ifilot/QS-80/pcb/components/TL16C2550PFBR.step

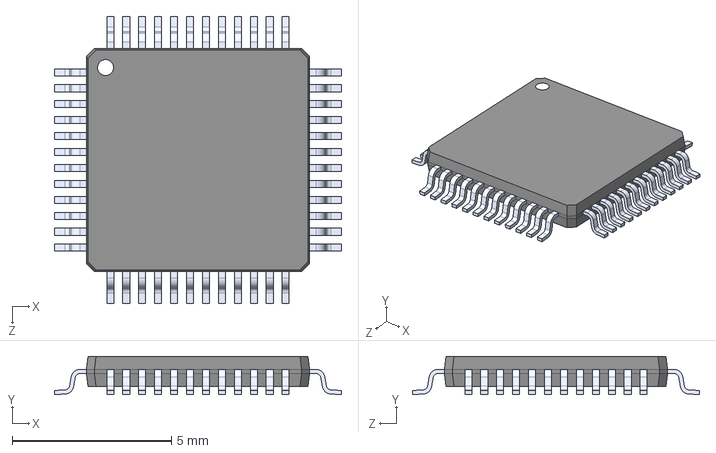
[picture p1: CAD file, 2026-08-23]
pcb/components/TL16C2550PFBR.step
9.00 x 1.20 x 9.00 mm
