ifilot/QS-80/pcb/qs-80-review.pdf

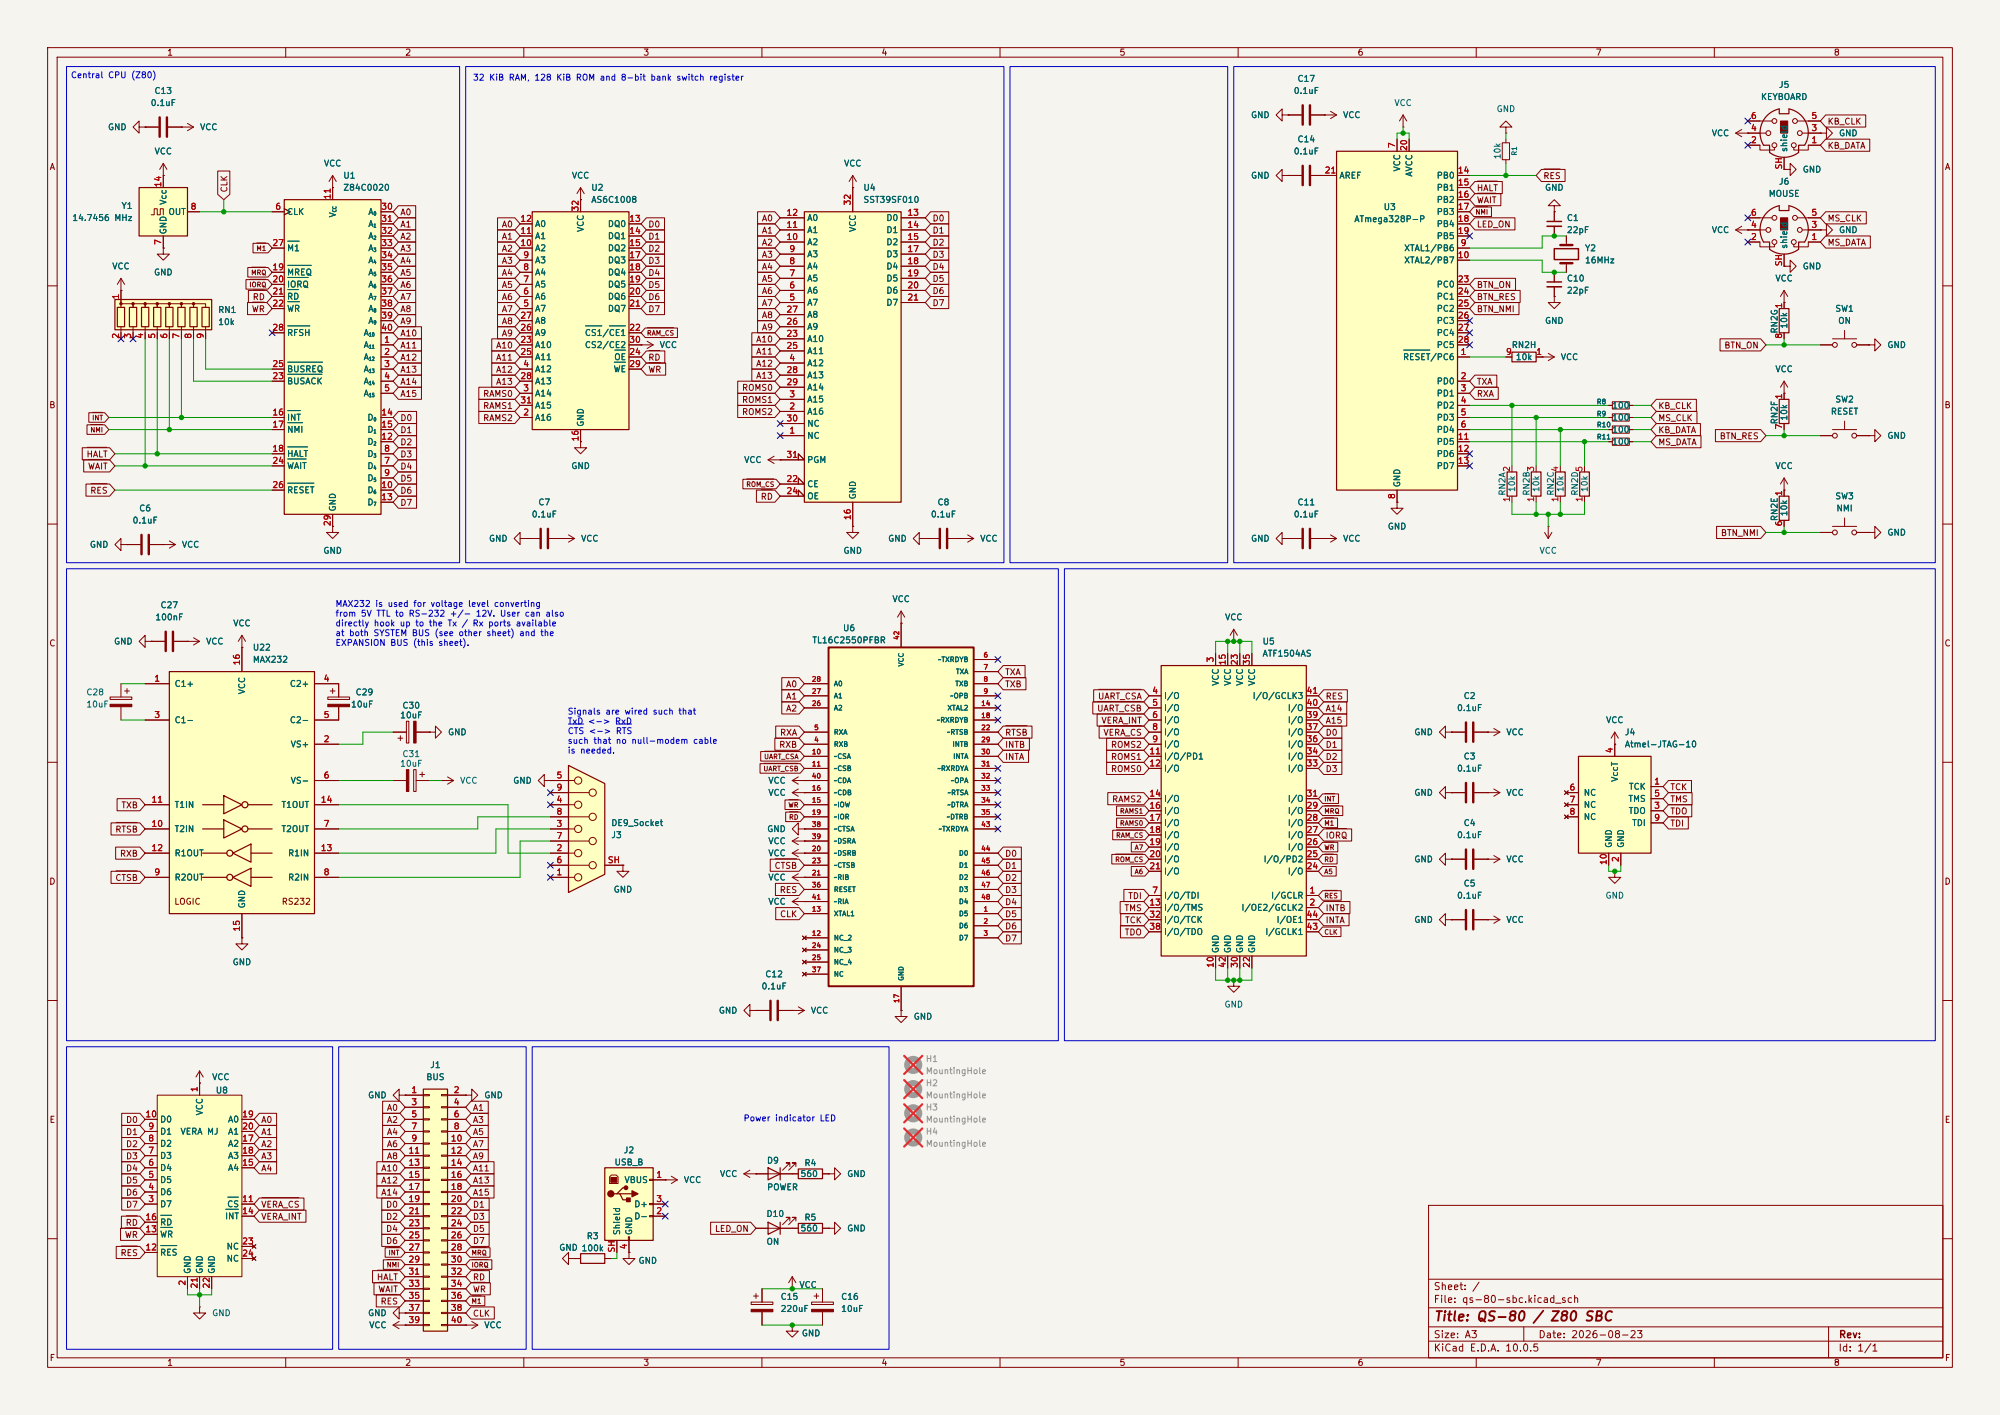
[picture p2: page 1]

32 KiB RAM, 128 KiB ROM and 8-bit bank switch register

VCC 11 D2 12 D7 13 D0 14 D1 15 INT 16 NMI 17 HALT 18 MREQ 19

from 5V TTL to RS-232 +/- 12V. User can also
directly hook up to the Tx / Rx ports available at both SYSTEM BUS (see other sheet) and the EXPANSION BUS (this sheet).

Signals are wired such that TxD <-> RxD

CTS <-> RTS
such that no null-modem cable
is needed.
