ifilot/QS-80/pcb/qs-80-sbc.kicad_pcb

## KiCad design pcb/qs-80-sbc.kicad_pcb (2026-08-30)

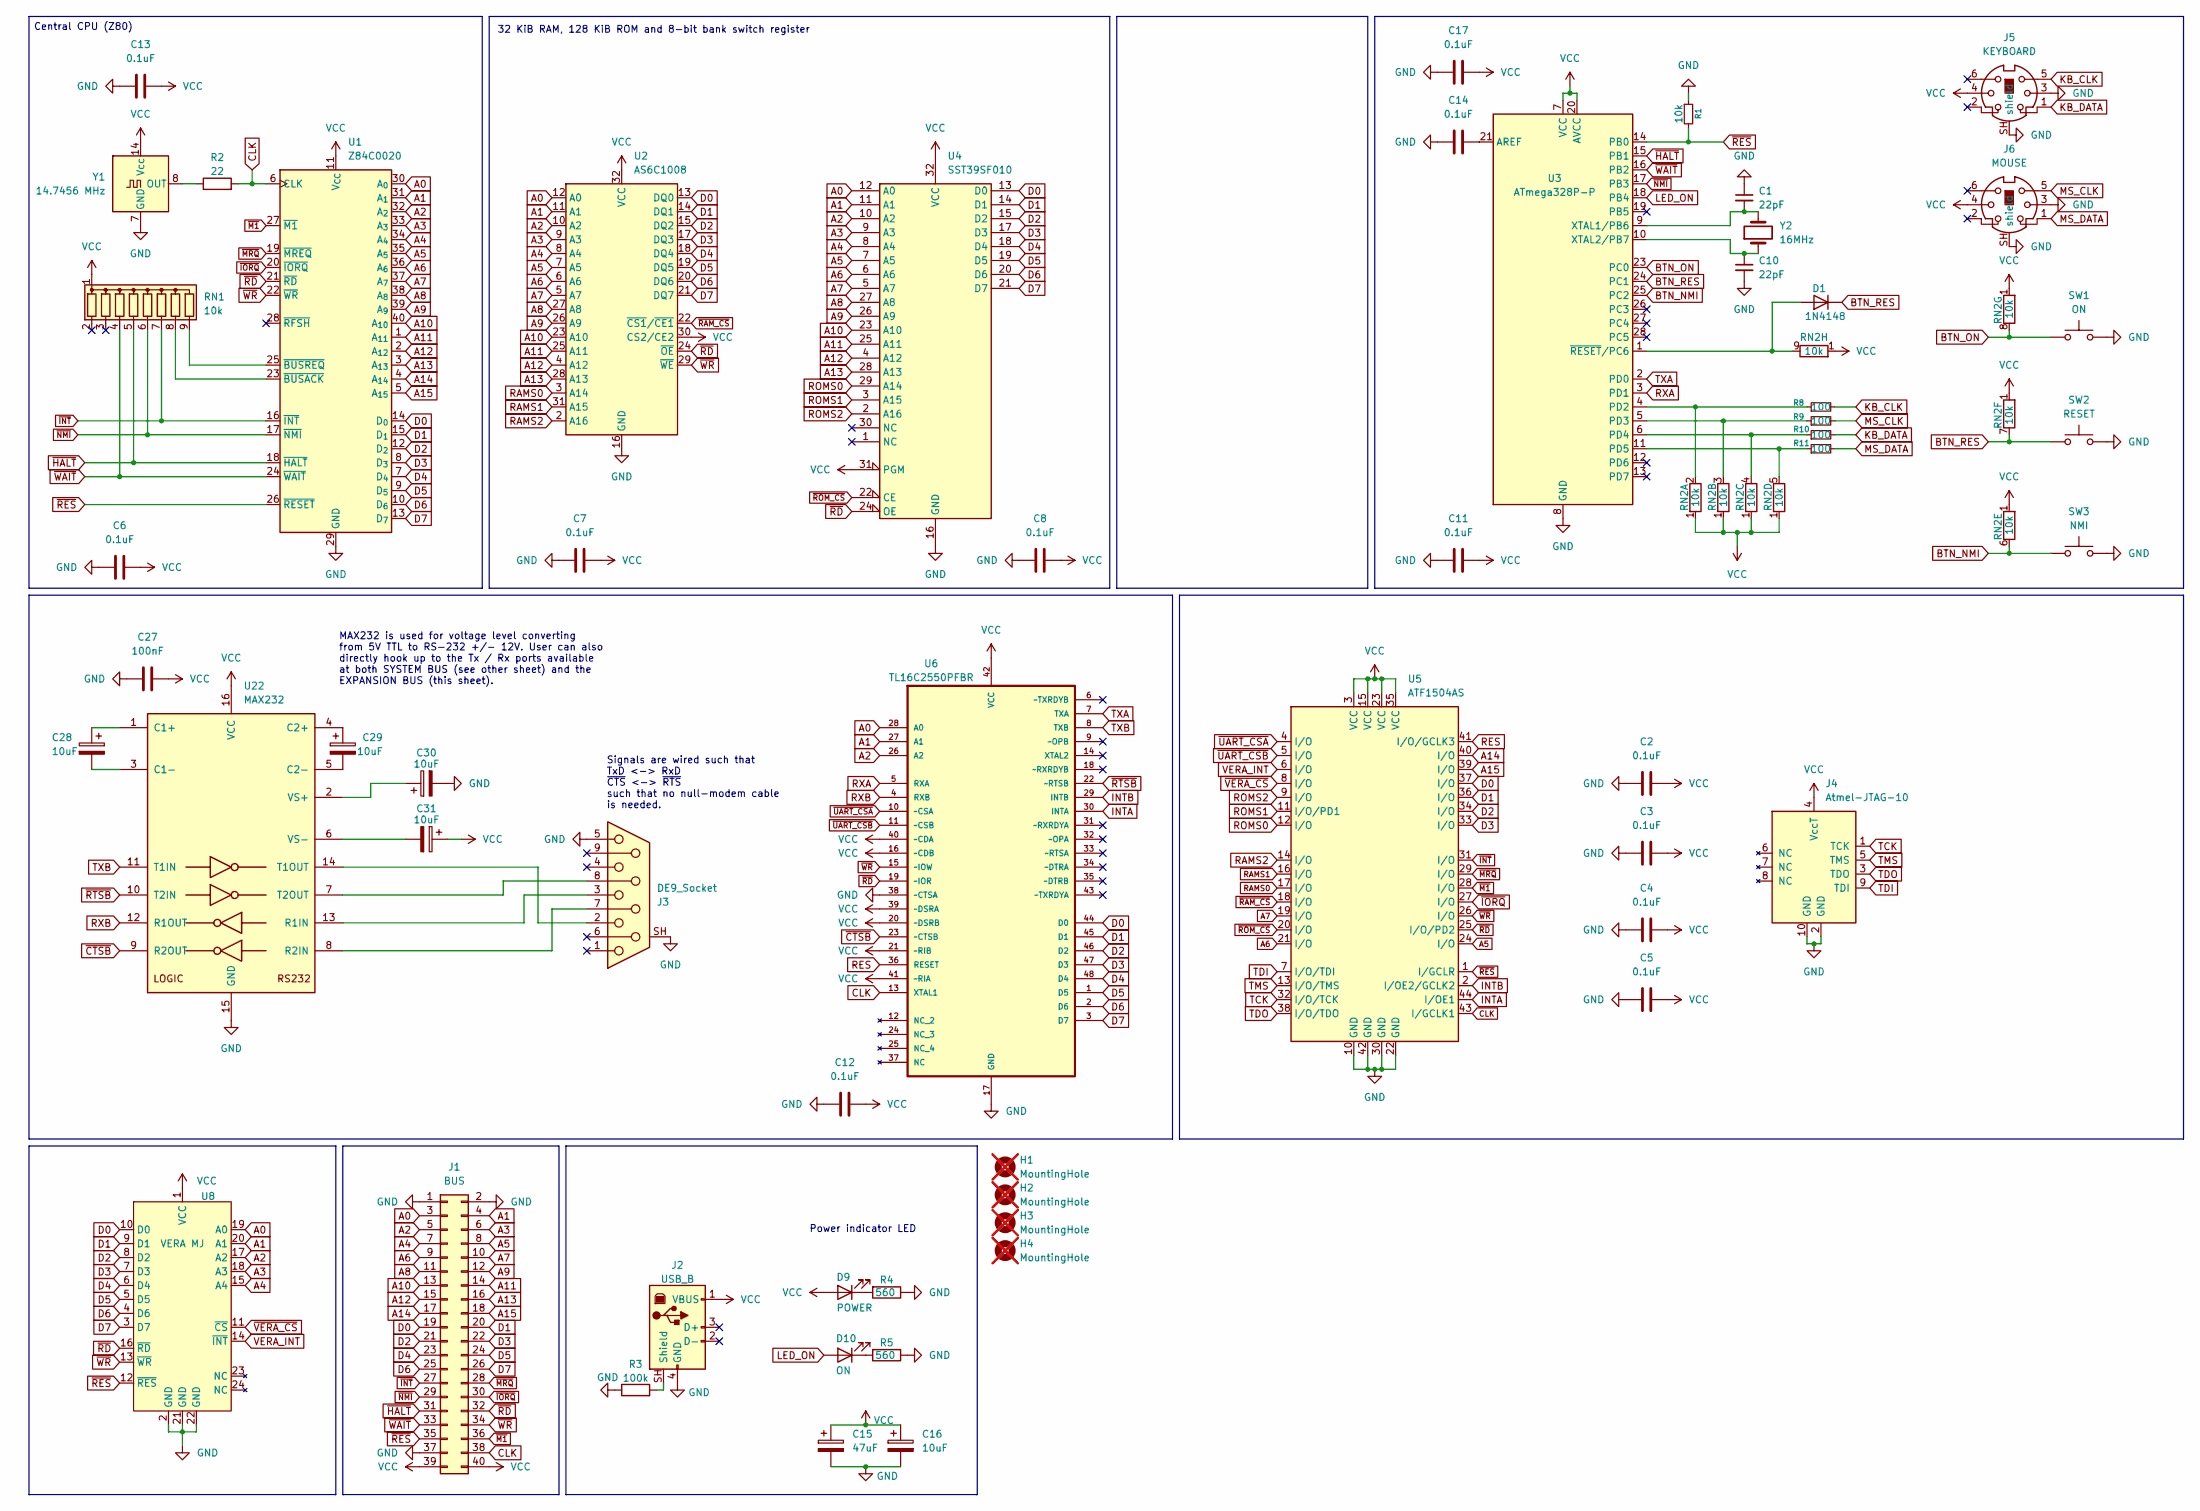
[picture p3: schematic qs-80-sbc.kicad_sch, QS-80 / Z80 SBC]

Parts:
C1, C10: 22pF; C_Disc_D5.0mm_W2.5mm_P5.00mm
C2, C3, C4, C5, C6, C7, C8, C11, C12, C13, C14, C17: 0.1uF; C_Disc_D5.0mm_W2.5mm_P5.00mm
C15: 47uF; CP_Radial_D6.3mm_P2.50mm
C16, C28, C29, C30, C31: 10uF; CP_Radial_D5.0mm_P2.50mm
C27: 100nF; C_Disc_D5.0mm_W2.5mm_P5.00mm
D1: 1N4148; D_DO-35_SOD27_P7.62mm_Horizontal
D9: POWER; LED_D5.0mm
D10: ON; LED_D5.0mm
H1, H2, H3, H4: MountingHole; MountingHole_3.2mm_M3_DIN965_Pad; not fitted
J1: BUS; PinHeader_2x20_P2.54mm_Vertical
J2: USB_B; USB_B_OST_USB-B1HSxx_Horizontal
J3: DE9_Socket; DSUB-9_Pins_Horizontal_P2.77x2.84mm_EdgePinOffset4.94mm_Hou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
J4: Atmel-JTAG-10; IDC-Header_2x05_P2.54mm_Vertical
J5: KEYBOARD; J_Mini-DIN-6
J6: MOUSE; J_Mini-DIN-6
R1: 10k; R_Axial_DIN0207_L6.3mm_D2.5mm_P7.62mm_Horizontal
R2: 22; R_Axial_DIN0207_L6.3mm_D2.5mm_P7.62mm_Horizontal
R3: 100k; R_Axial_DIN0207_L6.3mm_D2.5mm_P7.62mm_Horizontal
R4, R5: 560; R_Axial_DIN0207_L6.3mm_D2.5mm_P7.62mm_Horizontal
R8, R9, R10, R11: 100; R_Axial_DIN0207_L6.3mm_D2.5mm_P7.62mm_Horizontal
RN1, RN2: 10k; R_Array_SIP9
SW1: ON; SW_PUSH_6mm
SW2: RESET; SW_PUSH_6mm
SW3: NMI; SW_PUSH_6mm
U1: Z84C0020; DIP-40_W15.24mm_Socket
U2: AS6C1008; DIP-32_W15.24mm_Socket
U3: ATmega328P-P; DIP-28_W7.62mm_Socket
U4: SST39SF010; DIP-32_W15.24mm_Socket
U5: ATF1504AS; PLCC-44_THT-Socket
U6: TL16C2550PFBR; TQFP-48_7x7mm_P0.5mm; MPN TL16C2550PFBR
U8: VERA MJ; veraboard
U22: MAX232; DIP-16_W7.62mm_Socket
Y1: 14.7456 MHz; Oscillator_DIP-14
Y2: 16MHz; Crystal_HC49-U_Vertical

Connections:
A0: J1.3, U1.30 (A_{0}), U2.12 (A0), U4.12 (A0), U6.28 (A0), U8.19 (A0)
A1: J1.4, U1.31 (A_{1}), U2.11 (A1), U4.11 (A1), U6.27 (A1), U8.20 (A1)
A2: J1.5, U1.32 (A_{2}), U2.10 (A2), U4.10 (A2), U6.26 (A2), U8.17 (A2)
A3: J1.6, U1.33 (A_{3}), U2.9 (A3), U4.9 (A3), U8.18 (A3)
A4: J1.7, U1.34 (A_{4}), U2.8 (A4), U4.8 (A4), U8.15 (A4)
A5: J1.8, U1.35 (A_{5}), U2.7 (A5), U4.7 (A5), U5.24 (I/O)
A6: J1.9, U1.36 (A_{6}), U2.6 (A6), U4.6 (A6), U5.21 (I/O)
A7: J1.10, U1.37 (A_{7}), U2.5 (A7), U4.5 (A7), U5.19 (I/O)
A8: J1.11, U1.38 (A_{8}), U2.27 (A8), U4.27 (A8)
A9: J1.12, U1.39 (A_{9}), U2.26 (A9), U4.26 (A9)
A10: J1.13, U1.40 (A_{10}), U2.23 (A10), U4.23 (A10)
A11: J1.14, U1.1 (A_{11}), U2.25 (A11), U4.25 (A11)
A12: J1.15, U1.2 (A_{12}), U2.4 (A12), U4.4 (A12)
A13: J1.16, U1.3 (A_{13}), U2.28 (A13), U4.28 (A13)
A14: J1.17, U1.4 (A_{14}), U5.40 (I/O)
A15: J1.18, U1.5 (A_{15}), U5.39 (I/O)
BTN_NMI: RN2.6 (R5.2), SW3.1, U3.25 (PC2)
BTN_ON: RN2.8 (R7.2), SW1.1, U3.23 (PC0)
BTN_RES: D1.1 (K), RN2.7 (R6.2), SW2.1, U3.24 (PC1)
CLK: J1.38, R2.2, U1.6 (CLK), U5.43 (I/GCLK1), U6.13 (XTAL1)
D0: J1.19, U1.14 (D_{0}), U2.13 (DQ0), U4.13 (D0), U5.37 (I/O), U6.44 (D0), U8.10 (D0)
D1: J1.20, U1.15 (D_{1}), U2.14 (DQ1), U4.14 (D1), U5.36 (I/O), U6.45 (D1), U8.9 (D1)
D2: J1.21, U1.12 (D_{2}), U2.15 (DQ2), U4.15 (D2), U5.34 (I/O), U6.46 (D2), U8.8 (D2)
D3: J1.22, U1.8 (D_{3}), U2.17 (DQ3), U4.17 (D3), U5.33 (I/O), U6.47 (D3), U8.7 (D3)
D4: J1.23, U1.7 (D_{4}), U2.18 (DQ4), U4.18 (D4), U6.48 (D4), U8.6 (D4)
D5: J1.24, U1.9 (D_{5}), U2.19 (DQ5), U4.19 (D5), U6.1 (D5), U8.5 (D5)
D6: J1.25, U1.10 (D_{6}), U2.20 (DQ6), U4.20 (D6), U6.2 (D6), U8.4 (D6)
D7: J1.26, U1.13 (D_{7}), U2.21 (DQ7), U4.21 (D7), U6.3 (D7), U8.3 (D7)
GND: C1.1, C2.2, C3.2, C4.2, C5.2, C6.2, C7.2, C8.2, C10.2, C11.2, C12.2, C13.2, C14.2, C15.2, C16.2, C17.2, C27.2, C30.2, J1.1, J1.2, J1.37, J2.4 (GND), J3.5, J3.SH (shield), J4.2 (GND), J4.10 (GND), J5.3, J5.SH (shield_SH), J6.3, J6.SH (shield_SH), R1.1, R3.1, R4.1, R5.1, SW1.2, SW2.2, SW3.2, U1.29 (GND), U2.16 (GND), U3.8 (GND), U3.22 (GND), U4.16 (GND), U5.10 (GND), U5.22 (GND), U5.30 (GND), U5.42 (GND), U6.17 (GND), U6.38 (~CTSA), U8.2 (GND), U8.21 (GND), U8.22 (GND), U22.15 (GND), Y1.7 (GND)
INTA: U5.44 (I/OE1), U6.30 (INTA)
INTB: U5.2 (I/OE2/GCLK2), U6.29 (INTB)
KB_CLK: J5.5, R8.2
KB_DATA: J5.1, R10.2
LED_ON: D10.2 (A), U3.18 (PB4)
MS_CLK: J6.5, R9.2
MS_DATA: J6.1, R11.2
unnamed: D1.2 (A), RN2.9 (R8.2), U3.1 (~RESET/PC6)
unnamed: D9.1 (K), R4.2
unnamed: D10.1 (K), R5.2
unnamed: J2.SH (Shield), R3.2
unnamed: RN1.8 (R7), U1.23 (~BUSACK)
unnamed: RN1.9 (R8), U1.25 (~BUSREQ)
unnamed: R8.1, RN2.2 (R1.2), U3.4 (PD2)
unnamed: R9.1, RN2.3 (R2.2), U3.5 (PD3)
unnamed: R10.1, RN2.4 (R3.2), U3.6 (PD4)
unnamed: R11.1, RN2.5 (R4.2), U3.11 (PD5)
unnamed: C14.1, U3.21 (AREF)
unnamed: C1.2, U3.9 (XTAL1/PB6), Y2.2
unnamed: C10.1, U3.10 (XTAL2/PB7), Y2.1
unnamed: C28.1, U22.1 (C1+)
unnamed: C28.2, U22.3 (C1-)
unnamed: C29.1, U22.4 (C2+)
unnamed: C29.2, U22.5 (C2-)
unnamed: J3.3, U22.13 (R1IN)
unnamed: J3.7, U22.8 (R2IN)
unnamed: J3.2, U22.14 (T1OUT)
unnamed: J3.8, U22.7 (T2OUT)
unnamed: C30.1, U22.2 (VS+)
unnamed: C31.2, U22.6 (VS-)
unnamed: R2.1, Y1.8 (OUT)
RAMS0: U2.3 (A14), U5.17 (I/O)
RAMS1: U2.31 (A15), U5.16 (I/O)
RAMS2: U2.2 (A16), U5.14 (I/O)
RES: U5.41 (I/O/GCLK3), U6.36 (RESET)
ROMS0: U4.29 (A14), U5.12 (I/O)
ROMS1: U4.3 (A15), U5.11 (I/O/PD1)
ROMS2: U4.2 (A16), U5.9 (I/O)
RXA: U3.3 (PD1), U6.5 (RXA)
RXB: U6.4 (RXB), U22.12 (R1OUT)
TCK: J4.1 (TCK), U5.32 (I/O/TCK)
TDI: J4.9 (TDI), U5.7 (I/O/TDI)
TDO: J4.3 (TDO), U5.38 (I/O/TDO)
TMS: J4.5 (TMS), U5.13 (I/O/TMS)
TXA: U3.2 (PD0), U6.7 (TXA)
TXB: U6.8 (TXB), U22.11 (T1IN)
VCC: C2.1, C3.1, C4.1, C5.1, C6.1, C7.1, C8.1, C11.1, C12.1, C13.1, C15.1, C16.1, C17.1, C27.1, C31.1, D9.2 (A), J1.39, J1.40, J2.1 (VBUS), J4.4 (VccT), J5.4, J6.4, RN1.1 (common), RN2.1 (R1), U1.11 (V_{CC}), U2.30 (CS2/CE2), U2.32 (VCC), U3.7 (VCC), U3.20 (AVCC), U4.31 (PGM), U4.32 (VCC), U5.3 (VCC), U5.15 (VCC), U5.23 (VCC), U5.35 (VCC), U6.16 (~CDB), U6.20 (~DSRB), U6.21 (~RIB), U6.39 (~DSRA), U6.40 (~CDA), U6.41 (~RIA), U6.42 (VCC), U8.1 (VCC), U22.16 (VCC), Y1.14 (Vcc)
VERA_INT: U5.6 (I/O), U8.14 (~INT)
~CTSB: U6.23 (~CTSB), U22.9 (R2OUT)
~HALT: J1.31, RN1.5 (R4), U1.18 (~HALT), U3.15 (PB1)
~INT: J1.27, RN1.7 (R6), U1.16 (~INT), U5.31 (I/O)
~IORQ: J1.30, U1.20 (~IORQ), U5.27 (I/O)
~M1: J1.36, U1.27 (~M1), U5.28 (I/O)
~MRQ: J1.28, U1.19 (~MREQ), U5.29 (I/O)
~NMI: J1.29, RN1.6 (R5), U1.17 (~NMI), U3.17 (PB3)
~RAM_CS: U2.22 (~CS1/~CE1), U5.18 (I/O)
~RD: J1.32, U1.21 (~RD), U2.24 (~OE), U4.24 (OE), U5.25 (I/O/PD2), U6.19 (~IOR), U8.16 (~RD)
~RES: J1.35, R1.2, U1.26 (~RESET), U3.14 (PB0), U5.1 (I/GCLR), U8.12 (~RES)
~ROM_CS: U4.22 (CE), U5.20 (I/O)
~RTSB: U6.22 (~RTSB), U22.10 (T2IN)
~UART_CSA: U5.4 (I/O), U6.10 (~CSA)
~UART_CSB: U5.5 (I/O), U6.11 (~CSB)
~VERA_CS: U5.8 (I/O), U8.11 (~CS)
~WAIT: J1.33, RN1.4 (R3), U1.24 (~WAIT), U3.16 (PB2)
~WR: J1.34, U1.22 (~WR), U2.29 (~WE), U5.26 (I/O), U6.15 (~IOW), U8.13 (~WR)

Notes on the sheet:
32 KiB RAM, 128 KiB ROM and 8-bit bank switch register
Central CPU (Z80)
Signals are wired such that TxD <-> RxD ~{CTS} <-> ~{RTS} such that no null-modem cable is needed.
MAX232 is used for voltage level converting from 5V TTL to RS-232 +/- 12V. User can also directly hook up to the Tx / Rx ports available at both SYSTEM BUS (see other sheet) and the EXPANSION BUS (this sheet).
Power indicator LED

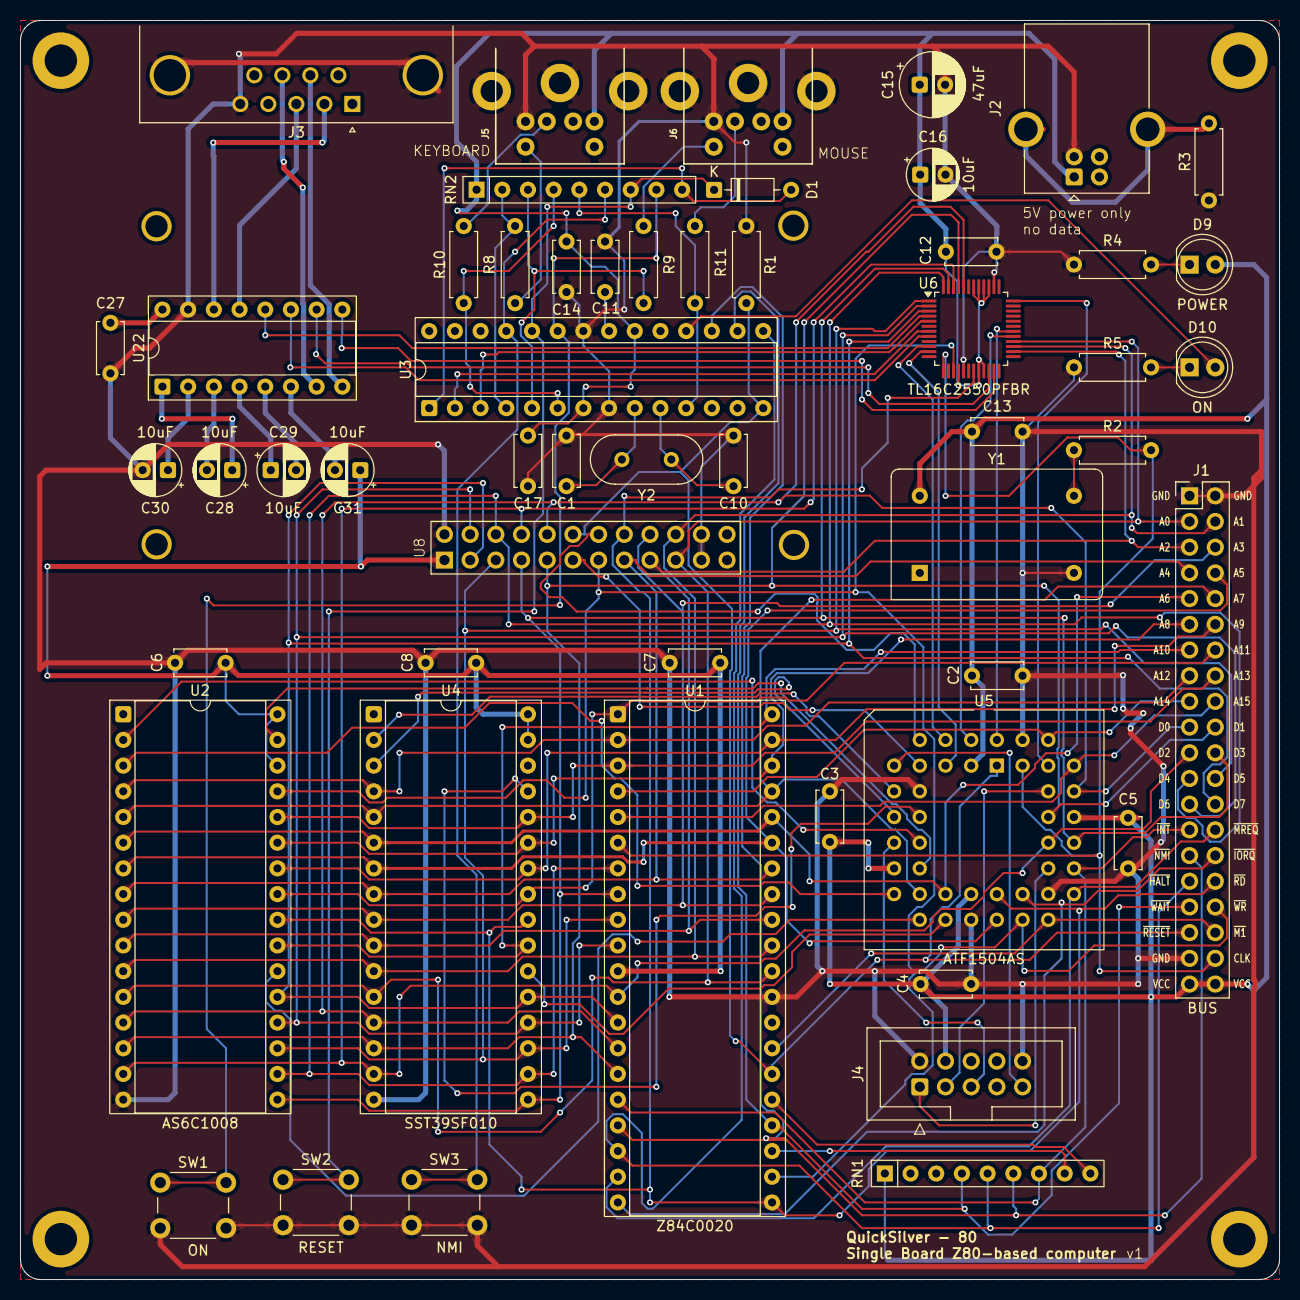
[picture p4: board qs-80-sbc.kicad_pcb from above]

Board: 2 copper layers, 124.5 x 124.5 mm, 58 parts (0 on the bottom side), 94 nets.
