ifilot/QS-80/(commit log)

2026-08-24 Adding 74HC138 for port mapping
    [qs-80-sbc.kicad_sch]
2026-08-24 Tuning I/O ports
    [qs-80-sbc.kicad_sch]
2026-08-30 Initial routing
    [qs-80-sbc.kicad_pcb, qs-80-sbc.kicad_sch]
2026-08-30 Completing routing phase 1
    [qs-80-sbc.kicad_pcb, qs-80-sbc.kicad_sch]
2026-08-30 Adding reset diode
    [qs-80-sbc.kicad_pcb, qs-80-sbc.kicad_sch]
